bjpati/Thesis-2023/README.md

# Thesis-2023
The goal of this thesis is to develop an embedded test system for monitoring current in a multiple channel neuromuscular electrical stimulation (NMES) system. The system is designed to detect overcurrent and leakage conditions and protect the patient from injury.
