bjpati/Thesis-2023/CircuitDesign/PCB_v10_new/THESIS_2023_v10.txt

For this version the design was changed because the previous design ware not work. The problem was in the common mode range of the
HV current sensing. instead the design was replaced with an instrumentation amplifier with voltage divider at the input. The PCB
needed to be re-routed.
