bjpati/Thesis-2023/CircuitDesign/PCB_v5/THESIS_2023_v5.txt

This is the fifth version where we have improved the PCB layout. In the previous version, the PCB became very large. 
In this version, we have reduced it by half. It is, however, still quite large, so we are thinking of making another new version where we 
utilize the back of the PCB more.
