bjpati/Thesis-2023/CircuitDesign/PCB_v9_final/NMEStestkort.xlsx

Id | Designator | Package | Quantity | Designation | Supplier and ref
1 | R12,R8,R29,R4,R27,R13,R2,R17,R26,R14,R23,R6,R9,R25,R10,R32,R31,R18,R16,R30,R19,R5,R3,R20,R24,R22,R21,R15,R1,R11,R28,R7 | R_0603_1608Metric_Pad0.98x0.95mm_HandSolder | 32 | 500
2 | Rout30,Rout10,Rout12,Rout18,Rout23,Rout32,Rout5,Rout6,Rout3,Rout29,Rout20,Rout31,Rout13,Rout26,Rout22,Rout21,Rout2,Rout27,Rout11,Rout8,Rout25,Rout9,Rout19,Rout15,Rout16,Rout17,Rout14,Rout4,Rout24,Rout28,Rout1,Rout7 | R_0603_1608Metric_Pad0.98x0.95mm_HandSolder | 32 | 10k
3 | Rin12,Rin29,Rin15,Rin9,Rin21,Rin3,Rin28,Rin17,Rin4,Rin16,Rin1,Rin13,Rin6,Rin19,Rin23,Rin5,Rin27,Rin7,Rin10,Rin8,Rin25,Rin30,Rin14,Rin18,Rin22,Rin11,Rin32,Rin31,Rin20,Rin26,Rin2,Rin24 | R_0603_1608Metric_Pad0.98x0.95mm_HandSolder | 32 | 150
4 | RDEV14,RDEV8,RDEV2,RDEV20,RDEV30,RDEV7,RDEV4,RDEV15,RDEV32,RDEV24,RDEV31,RDEV9,RDEV19,RDEV17,RDEV28,RDEV16,RDEV21,RDEV11,RDEV6,RDEV25,RDEV1,RDEV29,RDEV5,RDEV3,RDEV23,RDEV10,RDEV13,RDEV26,RDEV12,RDEV27,RDEV18 | R_0603_1608Metric_Pad0.98x0.95mm_HandSolder | 31 | 6k
5 | UHV21,UHV32,UHV30,UHV24,UHV2,UHV3,UHV7,UHV6,UHV12,UHV31,UHV14,UHV27,UHV17,UHV11,UHV8,UHV1,UHV25,UHV19,UHV5,UHV29,UHV20,UHV9,UHV16,UHV26,UHV28,UHV15,UHV10,UHV13,UHV4,UHV22,UHV18,UHV23 | SOT-23-5_HandSoldering | 32 | LT6106
6 | RDIV6,RDIV31,RDIV9,RDIV5,RDIV25,RDIV4,RDIV17,RDIV18,RDIV15,RDIV10,RDIV8,RDIV19,RDIV13,RDIV27,RDIV30,RDIV1,RDIV26,RDIV3,RDIV23,RDIV24,RDIV22,RDIV7,RDIV16,RDIV28,RDIV12,RDIV14,RDIV11,RDIV20,RDIV32,RDIV29,RDIV2,RDIV21 | R_0603_1608Metric_Pad0.98x0.95mm_HandSolder | 32 | 2k
7 | CUSB1,CReg1,CReg2,C10 | C_0805_2012Metric_Pad1.18x1.45mm_HandSolder | 4 | 1u
8 | RS9,RS1,RS32,RS26,RS8,RS19,RS10,RS18,RS14,RS3,RS4,RS13,RS30,RS20,RS31,RS17,RS29,RS25,RS21,RS15,RS7,RS27,RS24,RS28,RS22,RS12,RS2,RS6,RS16,RS5,RS11,RS23 | R_0603_1608Metric_Pad0.98x0.95mm_HandSolder | 32 | 1
9 | C11,C15,C12,C17,C16,C14,C18,C13 | CP_Elec_4x5.3 | 8 | 1u
10 | U1 | TSOT-23-5_HandSoldering | 1 | ADP151
11 | J4,J6 | PinSocket_1x03_P2.54mm_Vertical | 2 | Conn_01x03_Female
12 | JSTMleft1,JSTMright1 | PinSocket_1x15_P2.54mm_Vertical | 2 | Conn_01x15_Female
13 | H1,H4,H2,H3 | MountingHole_3.5mm_Pad | 4 | MountingHole
14 | J1,J2 | PinSocket_1x32_P2.54mm_Vertical | 2 | Conn_01x32_Female
15 | UCOM6,UCOM2,UCOM3,UCOM4,UCOM7,UCOM1,UCOM5,UCOM8 | TSSOP-14_4.4x5mm_P0.65mm | 8 | LM339
16 | C7,C6,C1,C4,C9,C3,C2,C8,C5 | C_0805_2012Metric_Pad1.18x1.45mm_HandSolder | 9 | 0.1u
17 | D1 | LED_1206_3216Metric_Pad1.42x1.75mm_HandSolder | 1 | LED
18 | TP1,TP4,TP2,TP3 | PinHeader_1x01_P2.54mm_Vertical | 4 | Conn_01x01_Female
19 | J3 | PinSocket_1x02_P2.54mm_Vertical | 1 | Conn_01x02_Female
20 | UDAC1 | MSOP-8_3x3mm_P0.65mm | 1 | MCP4921
21 | J7 | USB_Micro-B_Molex_47346-0001 | 1 | USB_B_Micro
22 | RDEV22,Rled1 | R_0603_1608Metric_Pad0.98x0.95mm_HandSolder | 2 | 1k
