bjpati/Thesis-2023/CircuitDesign/PCB_v11_final/NMEStestkort.kicad_pcb

## KiCad design CircuitDesign/PCB_v11_final/NMEStestkort.kicad_pcb (2023-05-22)

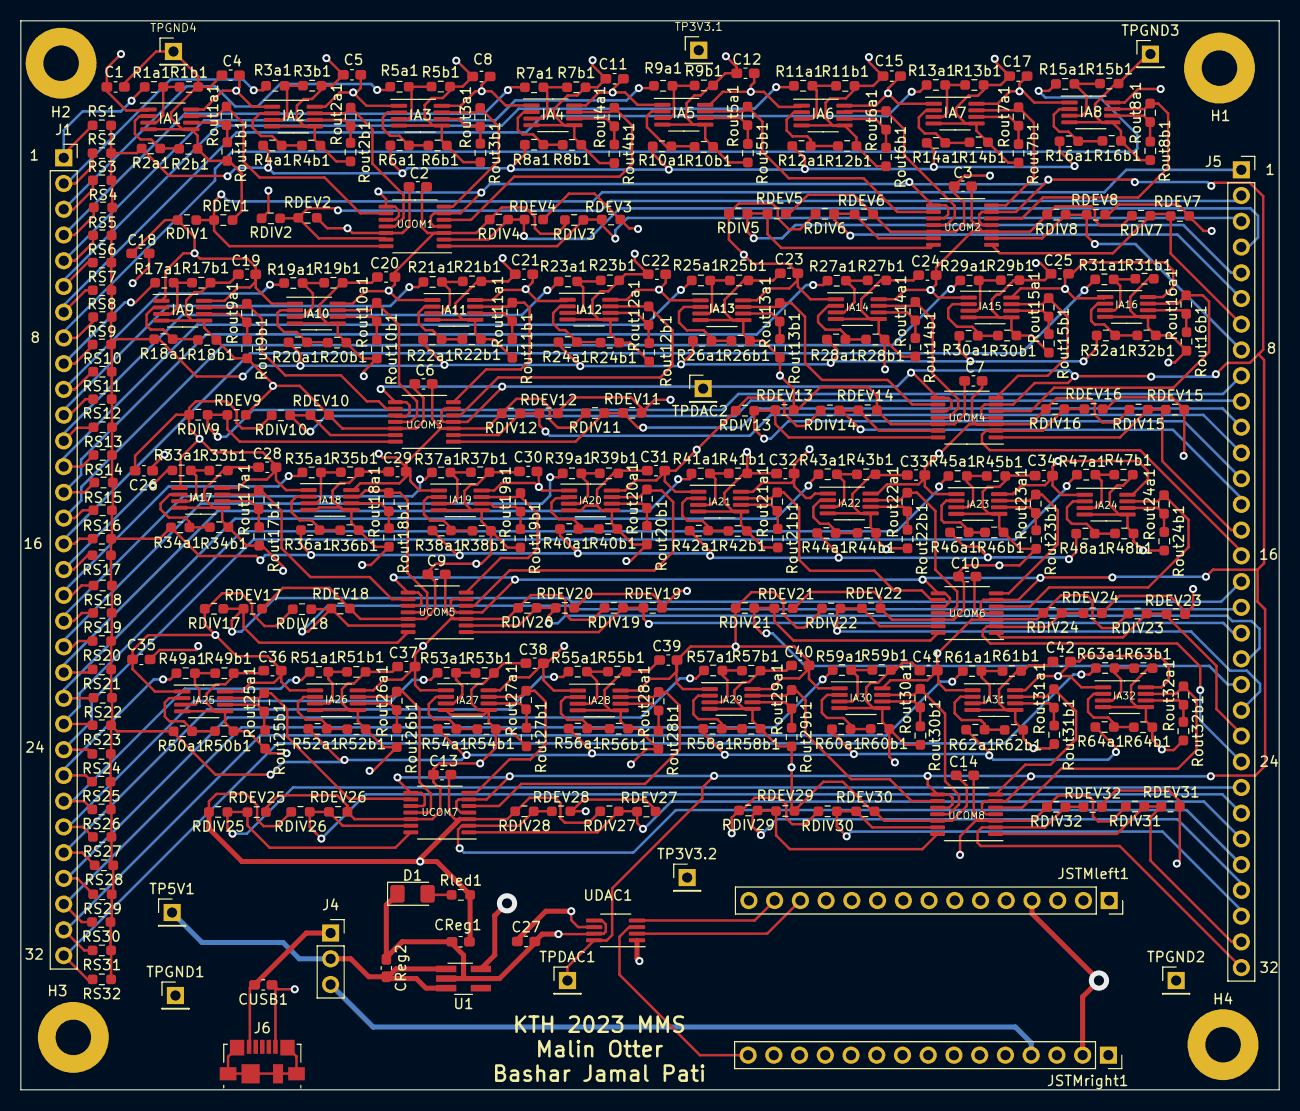
[picture p1: board CircuitDesign/PCB_v11_final/NMEStestkort.kicad_pcb from above]

Board: 4 copper layers, 124.2 x 105.5 mm, 395 parts (0 on the bottom side), 203 nets.

Parts:
C1, C2, C3, C4, C5, C6, C7, C8, C9, C10, C11, C12, C13, C14, C15, C17, C18, C19, C20, C21, C22, C23, C24, C25, C26, C27, C28, C29, C30, C31, C32, C33, C34, C35, C36, C37, C38, C39, C40, C41, C42: 0.1u; C_0603_1608Metric_Pad1.08x0.95mm_HandSolder
CReg1, CReg2: 1u; C_0603_1608Metric_Pad1.08x0.95mm_HandSolder
CUSB1: 1u; C_0603_1608Metric_Pad1.08x0.95mm_HandSolder
D1: LED; LED_1206_3216Metric_Pad1.42x1.75mm_HandSolder
H1, H2, H3, H4: MountingHole; MountingHole_3.5mm_Pad
IA1, IA2, IA3, IA4, IA5, IA6, IA7, IA8, IA9, IA10, IA11, IA12, IA13, IA14, IA15, IA16, IA17, IA18, IA19, IA20, IA21, IA22, IA23, IA24, IA25, IA26, IA27, IA28, IA29, IA30, IA31, IA32: MCP6N16; MSOP-8_3x3mm_P0.65mm
J1, J5: Conn_01x32_Female; PinSocket_1x32_P2.54mm_Vertical
J4: Conn_01x03_Female; PinSocket_1x03_P2.54mm_Vertical
J6: USB_B_Micro; USB_Micro-B_Molex_47346-0001
JSTMleft1: Conn_01x15_Female; PinSocket_1x15_P2.54mm_Vertical
JSTMright1: Conn_01x15_Female; PinSocket_1x15_P2.54mm_Vertical
R1a1, R2a1, R3a1, R4a1, R5a1, R6a1, R7a1, R8a1, R9a1, R10a1, R11a1, R12a1, R13a1, R14a1, R15a1, R16a1, R17a1, R18a1, R19a1, R20a1, R21a1, R22a1, R23a1, R24a1, R25a1, R26a1, R27a1, R28a1, R29a1, R30a1, R31a1, R32a1, R33a1, R34a1, R35a1, R36a1, R37a1, R38a1, R39a1, R40a1, R41a1, R42a1, R43a1, R44a1, R45a1, R46a1, R47a1, R48a1, R49a1, R50a1, R51a1, R52a1, R53a1, R54a1, R55a1, R56a1, R57a1, R58a1, R59a1, R60a1, R61a1, R62a1, R63a1, R64a1: 47k; R_0603_1608Metric_Pad0.98x0.95mm_HandSolder
R1b1, R2b1, R3b1, R4b1, R5b1, R6b1, R7b1, R8b1, R9b1, R10b1, R11b1, R12b1, R13b1, R14b1, R15b1, R16b1, R17b1, R18b1, R19b1, R20b1, R21b1, R22b1, R23b1, R24b1, R25b1, R26b1, R27b1, R28b1, R29b1, R30b1, R31b1, R32b1, R33b1, R34b1, R35b1, R36b1, R37b1, R38b1, R39b1, R40b1, R41b1, R42b1, R43b1, R44b1, R45b1, R46b1, R47b1, R48b1, R49b1, R50b1, R51b1, R52b1, R53b1, R54b1, R55b1, R56b1, R57b1, R58b1, R59b1, R60b1, R61b1, R62b1, R63b1, R64b1: 470; R_0603_1608Metric_Pad0.98x0.95mm_HandSolder
RDEV1, RDEV2, RDEV3, RDEV4, RDEV5, RDEV6, RDEV7, RDEV8, RDEV9, RDEV10, RDEV11, RDEV12, RDEV13, RDEV14, RDEV15, RDEV16, RDEV17, RDEV18, RDEV19, RDEV20, RDEV21, RDEV22, RDEV23, RDEV24, RDEV25, RDEV26, RDEV27, RDEV28, RDEV29, RDEV30, RDEV31, RDEV32: 6k2; R_0603_1608Metric_Pad0.98x0.95mm_HandSolder
RDIV1, RDIV2, RDIV3, RDIV4, RDIV5, RDIV6, RDIV7, RDIV8, RDIV9, RDIV10, RDIV11, RDIV12, RDIV13, RDIV14, RDIV15, RDIV16, RDIV17, RDIV18, RDIV19, RDIV20, RDIV21, RDIV22, RDIV23, RDIV24, RDIV25, RDIV26, RDIV27, RDIV28, RDIV29, RDIV30, RDIV31, RDIV32: 2k2; R_0603_1608Metric_Pad0.98x0.95mm_HandSolder
RS1, RS2, RS3, RS4, RS5, RS6, RS7, RS8, RS9, RS10, RS11, RS12, RS13, RS14, RS15, RS16, RS17, RS18, RS19, RS20, RS21, RS22, RS23, RS24, RS25, RS26, RS27, RS28, RS29, RS30, RS31, RS32: 500; R_0603_1608Metric_Pad0.98x0.95mm_HandSolder
Rled1: 1k; R_0603_1608Metric_Pad0.98x0.95mm_HandSolder
Rout1a1, Rout2a1, Rout3a1, Rout4a1, Rout5a1, Rout6a1, Rout7a1, Rout8a1, Rout9a1, Rout10a1, Rout11a1, Rout12a1, Rout13a1, Rout14a1, Rout15a1, Rout16a1, Rout17a1, Rout18a1, Rout19a1, Rout20a1, Rout21a1, Rout22a1, Rout23a1, Rout24a1, Rout25a1, Rout26a1, Rout27a1, Rout28a1, Rout29a1, Rout30a1, Rout31a1, Rout32a1: 12k; R_0603_1608Metric_Pad0.98x0.95mm_HandSolder
Rout1b1, Rout2b1, Rout3b1, Rout4b1, Rout5b1, Rout6b1, Rout7b1, Rout8b1, Rout9b1, Rout10b1, Rout11b1, Rout12b1, Rout13b1, Rout14b1, Rout15b1, Rout16b1, Rout17b1, Rout18b1, Rout19b1, Rout20b1, Rout21b1, Rout22b1, Rout23b1, Rout24b1, Rout25b1, Rout26b1, Rout27b1, Rout28b1, Rout29b1, Rout30b1, Rout31b1, Rout32b1: 1k; R_0603_1608Metric_Pad0.98x0.95mm_HandSolder
TP3V3.1, TP3V3.2: Conn_01x02_Female; PinHeader_1x01_P2.54mm_Vertical
TP5V1: Conn_01x01_Female; PinHeader_1x01_P2.54mm_Vertical
TPDAC1, TPDAC2: Conn_01x01_Female; PinHeader_1x01_P2.54mm_Vertical
TPGND1, TPGND2, TPGND3, TPGND4: Conn_01x02_Female; PinHeader_1x01_P2.54mm_Vertical
U1: ADP151; TSOT-23-5_HandSoldering
UCOM1, UCOM2, UCOM3, UCOM4, UCOM5, UCOM6, UCOM7, UCOM8: LM339; TSSOP-14_4.4x5mm_P0.65mm
UDAC1: MCP4921; MSOP-8_3x3mm_P0.65mm

Connections:
+3.3V: C1.1, C2.1, C3.1, C4.1, C5.1, C6.1, C7.1, C8.1, C9.1, C10.1, C11.1, C12.1, C13.1, C14.1, C15.1, C17.1, C18.1, C19.1, C20.1, C21.1, C22.1, C23.1, C24.1, C25.1, C26.1, C27.1, C28.1, C29.1, C30.1, C31.1, C32.1, C33.1, C34.1, C35.1, C36.1, C37.1, C38.1, C39.1, C40.1, C41.1, C42.1, CReg1.1, IA1.1 (EN), IA1.8 (V+), IA2.1 (EN), IA2.8 (V+), IA3.1 (EN), IA3.8 (V+), IA4.1 (EN), IA4.8 (V+), IA5.1 (EN), IA5.8 (V+), IA6.1 (EN), IA6.8 (V+), IA7.1 (EN), IA7.8 (V+), IA8.1 (EN), IA8.8 (V+), IA9.1 (EN), IA9.8 (V+), IA10.1 (EN), IA10.8 (V+), IA11.1 (EN), IA11.8 (V+), IA12.1 (EN), IA12.8 (V+), IA13.1 (EN), IA13.8 (V+), IA14.1 (EN), IA14.8 (V+), IA15.1 (EN), IA15.8 (V+), IA16.1 (EN), IA16.8 (V+), IA17.1 (EN), IA17.8 (V+), IA18.1 (EN), IA18.8 (V+), IA19.1 (EN), IA19.8 (V+), IA20.1 (EN), IA20.8 (V+), IA21.1 (EN), IA21.8 (V+), IA22.1 (EN), IA22.8 (V+), IA23.1 (EN), IA23.8 (V+), IA24.1 (EN), IA24.8 (V+), IA25.1 (EN), IA25.8 (V+), IA26.1 (EN), IA26.8 (V+), IA27.1 (EN), IA27.8 (V+), IA28.1 (EN), IA28.8 (V+), IA29.1 (EN), IA29.8 (V+), IA30.1 (EN), IA30.8 (V+), IA31.1 (EN), IA31.8 (V+), IA32.1 (EN), IA32.8 (V+), RDIV1.2, RDIV2.2, RDIV3.2, RDIV4.2, RDIV5.2, RDIV6.2, RDIV7.2, RDIV8.2, RDIV9.2, RDIV10.2, RDIV11.2, RDIV12.2, RDIV13.2, RDIV14.2, RDIV15.2, RDIV16.2, RDIV17.2, RDIV18.2, RDIV19.2, RDIV20.2, RDIV21.2, RDIV22.2, RDIV23.2, RDIV24.2, RDIV25.2, RDIV26.2, RDIV27.2, RDIV28.2, RDIV29.2, RDIV30.2, RDIV31.2, RDIV32.2, Rled1.2, TP3V3.1.1, TP3V3.2.1, U1.5 (VOUT), UCOM1.3 (V+), UCOM2.3 (V+), UCOM3.3 (V+), UCOM4.3 (V+), UCOM5.3 (V+), UCOM6.3 (V+), UCOM7.3 (V+), UCOM8.3 (V+), UDAC1.1 (Vdd), UDAC1.6 (Vref)
+5V: CReg2.2, J4.2, TP5V1.1, U1.1 (VIN), U1.3 (EN)
+5V MCU: J4.3, JSTMright1.4
+5V USB: CUSB1.2, J4.1, J6.1 (VBUS)
DAC output: TPDAC1.1, TPDAC2.1, UCOM1.4 (-), UCOM1.6 (-), UCOM1.8 (-), UCOM1.10 (-), UCOM2.4 (-), UCOM2.6 (-), UCOM2.8 (-), UCOM2.10 (-), UCOM3.4 (-), UCOM3.6 (-), UCOM3.8 (-), UCOM3.10 (-), UCOM4.4 (-), UCOM4.6 (-), UCOM4.8 (-), UCOM4.10 (-), UCOM5.4 (-), UCOM5.6 (-), UCOM5.8 (-), UCOM5.10 (-), UCOM6.4 (-), UCOM6.6 (-), UCOM6.8 (-), UCOM6.10 (-), UCOM7.4 (-), UCOM7.6 (-), UCOM7.8 (-), UCOM7.10 (-), UCOM8.4 (-), UCOM8.6 (-), UCOM8.8 (-), UCOM8.10 (-), UDAC1.8 (Vout)
GND: C1.2, C2.2, C3.2, C4.2, C5.2, C6.2, C7.2, C8.2, C9.2, C10.2, C11.2, C12.2, C13.2, C14.2, C15.2, C17.2, C18.2, C19.2, C20.2, C21.2, C22.2, C23.2, C24.2, C25.2, C26.2, C27.2, C28.2, C29.2, C30.2, C31.2, C32.2, C33.2, C34.2, C35.2, C36.2, C37.2, C38.2, C39.2, C40.2, C41.2, C42.2, CReg1.2, CReg2.1, CUSB1.1, D1.1 (K), IA1.4 (V-), IA1.5 (Vref), IA2.4 (V-), IA2.5 (Vref), IA3.4 (V-), IA3.5 (Vref), IA4.4 (V-), IA4.5 (Vref), IA5.4 (V-), IA5.5 (Vref), IA6.4 (V-), IA6.5 (Vref), IA7.4 (V-), IA7.5 (Vref), IA8.4 (V-), IA8.5 (Vref), IA9.4 (V-), IA9.5 (Vref), IA10.4 (V-), IA10.5 (Vref), IA11.4 (V-), IA11.5 (Vref), IA12.4 (V-), IA12.5 (Vref), IA13.4 (V-), IA13.5 (Vref), IA14.4 (V-), IA14.5 (Vref), IA15.4 (V-), IA15.5 (Vref), IA16.4 (V-), IA16.5 (Vref), IA17.4 (V-), IA17.5 (Vref), IA18.4 (V-), IA18.5 (Vref), IA19.4 (V-), IA19.5 (Vref), IA20.4 (V-), IA20.5 (Vref), IA21.4 (V-), IA21.5 (Vref), IA22.4 (V-), IA22.5 (Vref), IA23.4 (V-), IA23.5 (Vref), IA24.4 (V-), IA24.5 (Vref), IA25.4 (V-), IA25.5 (Vref), IA26.4 (V-), IA26.5 (Vref), IA27.4 (V-), IA27.5 (Vref), IA28.4 (V-), IA28.5 (Vref), IA29.4 (V-), IA29.5 (Vref), IA30.4 (V-), IA30.5 (Vref), IA31.4 (V-), IA31.5 (Vref), IA32.4 (V-), IA32.5 (Vref), J6.5 (GND), JSTMleft1.4, JSTMright1.2, R1b1.2, R2b1.2, R3b1.2, R4b1.2, R5b1.2, R6b1.2, R7b1.2, R8b1.2, R9b1.2, R10b1.2, R11b1.2, R12b1.2, R13b1.2, R14b1.2, R15b1.2, R16b1.2, R17b1.2, R18b1.2, R19b1.2, R20b1.2, R21b1.2, R22b1.2, R23b1.2, R24b1.2, R25b1.2, R26b1.2, R27b1.2, R28b1.2, R29b1.2, R30b1.2, R31b1.2, R32b1.2, R33b1.2, R34b1.2, R35b1.2, R36b1.2, R37b1.2, R38b1.2, R39b1.2, R40b1.2, R41b1.2, R42b1.2, R43b1.2, R44b1.2, R45b1.2, R46b1.2, R47b1.2, R48b1.2, R49b1.2, R50b1.2, R51b1.2, R52b1.2, R53b1.2, R54b1.2, R55b1.2, R56b1.2, R57b1.2, R58b1.2, R59b1.2, R60b1.2, R61b1.2, R62b1.2, R63b1.2, R64b1.2, RDEV1.1, RDEV2.1, RDEV3.1, RDEV4.1, RDEV5.1, RDEV6.1, RDEV7.1, RDEV8.1, RDEV9.1, RDEV10.1, RDEV11.1, RDEV12.1, RDEV13.1, RDEV14.1, RDEV15.1, RDEV16.1, RDEV17.1, RDEV18.1, RDEV19.1, RDEV20.1, RDEV21.1, RDEV22.1, RDEV23.1, RDEV24.1, RDEV25.1, RDEV26.1, RDEV27.1, RDEV28.1, RDEV29.1, RDEV30.1, RDEV31.1, RDEV32.1, Rout1b1.2, Rout2b1.2, Rout3b1.2, Rout4b1.2, Rout5b1.2, Rout6b1.2, Rout7b1.2, Rout8b1.2, Rout9b1.2, Rout10b1.2, Rout11b1.2, Rout12b1.2, Rout13b1.2, Rout14b1.2, Rout15b1.2, Rout16b1.2, Rout17b1.2, Rout18b1.2, Rout19b1.2, Rout20b1.2, Rout21b1.2, Rout22b1.2, Rout23b1.2, Rout24b1.2, Rout25b1.2, Rout26b1.2, Rout27b1.2, Rout28b1.2, Rout29b1.2, Rout30b1.2, Rout31b1.2, Rout32b1.2, TPGND1.1, TPGND2.1, TPGND3.1, TPGND4.1, U1.2 (GND), UCOM1.12 (V-), UCOM2.12 (V-), UCOM3.12 (V-), UCOM4.12 (V-), UCOM5.12 (V-), UCOM6.12 (V-), UCOM7.12 (V-), UCOM8.12 (V-), UDAC1.5 (~LDAC), UDAC1.7 (Vss)
unnamed: D1.2 (A), Rled1.1
unnamed: IA1.2 (-), R2a1.1, R2b1.1
unnamed: IA1.3 (+), R1a1.1, R1b1.1
unnamed: IA1.6 (Vfg), Rout1a1.1, Rout1b1.1
unnamed: IA1.7 (Vout), Rout1a1.2, UCOM1.9 (+)
unnamed: IA2.2 (-), R4a1.1, R4b1.1
unnamed: IA2.3 (+), R3a1.1, R3b1.1
unnamed: IA2.6 (Vfg), Rout2a1.1, Rout2b1.1
unnamed: IA2.7 (Vout), Rout2a1.2, UCOM1.11 (+)
unnamed: IA3.2 (-), R6a1.1, R6b1.1
unnamed: IA3.3 (+), R5a1.1, R5b1.1
unnamed: IA3.6 (Vfg), Rout3a1.1, Rout3b1.1
unnamed: IA3.7 (Vout), Rout3a1.2, UCOM1.7 (+)
unnamed: IA4.2 (-), R8a1.1, R8b1.1
unnamed: IA4.3 (+), R7a1.1, R7b1.1
unnamed: IA4.6 (Vfg), Rout4a1.1, Rout4b1.1
unnamed: IA4.7 (Vout), Rout4a1.2, UCOM1.5 (+)
unnamed: IA5.2 (-), R10a1.1, R10b1.1
unnamed: IA5.3 (+), R9a1.1, R9b1.1
unnamed: IA5.6 (Vfg), Rout5a1.1, Rout5b1.1
unnamed: IA5.7 (Vout), Rout5a1.2, UCOM2.9 (+)
unnamed: IA6.2 (-), R12a1.1, R12b1.1
unnamed: IA6.3 (+), R11a1.1, R11b1.1
unnamed: IA6.6 (Vfg), Rout6a1.1, Rout6b1.1
unnamed: IA6.7 (Vout), Rout6a1.2, UCOM2.11 (+)
unnamed: IA7.2 (-), R14a1.1, R14b1.1
unnamed: IA7.3 (+), R13a1.1, R13b1.1
unnamed: IA7.6 (Vfg), Rout7a1.1, Rout7b1.1
unnamed: IA7.7 (Vout), Rout7a1.2, UCOM2.7 (+)
unnamed: IA8.2 (-), R16a1.1, R16b1.1
unnamed: IA8.3 (+), R15a1.1, R15b1.1
unnamed: IA8.6 (Vfg), Rout8a1.1, Rout8b1.1
unnamed: IA8.7 (Vout), Rout8a1.2, UCOM2.5 (+)
unnamed: IA9.2 (-), R18a1.1, R18b1.1
unnamed: IA9.3 (+), R17a1.1, R17b1.1
unnamed: IA9.6 (Vfg), Rout9a1.1, Rout9b1.1
unnamed: IA9.7 (Vout), Rout9a1.2, UCOM3.9 (+)
unnamed: IA10.2 (-), R20a1.1, R20b1.1
unnamed: IA10.3 (+), R19a1.1, R19b1.1
unnamed: IA10.6 (Vfg), Rout10a1.1, Rout10b1.1
unnamed: IA10.7 (Vout), Rout10a1.2, UCOM3.11 (+)
unnamed: IA11.2 (-), R22a1.1, R22b1.1
unnamed: IA11.3 (+), R21a1.1, R21b1.1
unnamed: IA11.6 (Vfg), Rout11a1.1, Rout11b1.1
unnamed: IA11.7 (Vout), Rout11a1.2, UCOM3.7 (+)
unnamed: IA12.2 (-), R24a1.1, R24b1.1
unnamed: IA12.3 (+), R23a1.1, R23b1.1
unnamed: IA12.6 (Vfg), Rout12a1.1, Rout12b1.1
unnamed: IA12.7 (Vout), Rout12a1.2, UCOM3.5 (+)
unnamed: IA13.2 (-), R26a1.1, R26b1.1
unnamed: IA13.3 (+), R25a1.1, R25b1.1
unnamed: IA13.6 (Vfg), Rout13a1.1, Rout13b1.1
unnamed: IA13.7 (Vout), Rout13a1.2, UCOM4.9 (+)
unnamed: IA14.2 (-), R28a1.1, R28b1.1
unnamed: IA14.3 (+), R27a1.1, R27b1.1
unnamed: IA14.6 (Vfg), Rout14a1.1, Rout14b1.1
unnamed: IA14.7 (Vout), Rout14a1.2, UCOM4.11 (+)
unnamed: IA15.2 (-), R30a1.1, R30b1.1
unnamed: IA15.3 (+), R29a1.1, R29b1.1
unnamed: IA15.6 (Vfg), Rout15a1.1, Rout15b1.1
unnamed: IA15.7 (Vout), Rout15a1.2, UCOM4.7 (+)
unnamed: IA16.2 (-), R32a1.1, R32b1.1
unnamed: IA16.3 (+), R31a1.1, R31b1.1
unnamed: IA16.6 (Vfg), Rout16a1.1, Rout16b1.1
unnamed: IA16.7 (Vout), Rout16a1.2, UCOM4.5 (+)
unnamed: IA17.2 (-), R34a1.1, R34b1.1
unnamed: IA17.3 (+), R33a1.1, R33b1.1
unnamed: IA17.6 (Vfg), Rout17a1.1, Rout17b1.1
unnamed: IA17.7 (Vout), Rout17a1.2, UCOM5.9 (+)
unnamed: IA18.2 (-), R36a1.1, R36b1.1
unnamed: IA18.3 (+), R35a1.1, R35b1.1
unnamed: IA18.6 (Vfg), Rout18a1.1, Rout18b1.1
unnamed: IA18.7 (Vout), Rout18a1.2, UCOM5.11 (+)
unnamed: IA19.2 (-), R38a1.1, R38b1.1
unnamed: IA19.3 (+), R37a1.1, R37b1.1
unnamed: IA19.6 (Vfg), Rout19a1.1, Rout19b1.1
unnamed: IA19.7 (Vout), Rout19a1.2, UCOM5.7 (+)
unnamed: IA20.2 (-), R40a1.1, R40b1.1
unnamed: IA20.3 (+), R39a1.1, R39b1.1
unnamed: IA20.6 (Vfg), Rout20a1.1, Rout20b1.1
unnamed: IA20.7 (Vout), Rout20a1.2, UCOM5.5 (+)
unnamed: IA21.2 (-), R42a1.1, R42b1.1
unnamed: IA21.3 (+), R41a1.1, R41b1.1
unnamed: IA21.6 (Vfg), Rout21a1.1, Rout21b1.1
unnamed: IA21.7 (Vout), Rout21a1.2, UCOM6.9 (+)
unnamed: IA22.2 (-), R44a1.1, R44b1.1
unnamed: IA22.3 (+), R43a1.1, R43b1.1
unnamed: IA22.6 (Vfg), Rout22a1.1, Rout22b1.1
unnamed: IA22.7 (Vout), Rout22a1.2, UCOM6.11 (+)
unnamed: IA23.2 (-), R46a1.1, R46b1.1
unnamed: IA23.3 (+), R45a1.1, R45b1.1
unnamed: IA23.6 (Vfg), Rout23a1.1, Rout23b1.1
unnamed: IA23.7 (Vout), Rout23a1.2, UCOM6.7 (+)
unnamed: IA24.2 (-), R48a1.1, R48b1.1
unnamed: IA24.3 (+), R47a1.1, R47b1.1
unnamed: IA24.6 (Vfg), Rout24a1.1, Rout24b1.1
unnamed: IA24.7 (Vout), Rout24a1.2, UCOM6.5 (+)
unnamed: IA25.2 (-), R50a1.1, R50b1.1
unnamed: IA25.3 (+), R49a1.1, R49b1.1
unnamed: IA25.6 (Vfg), Rout25a1.1, Rout25b1.1
unnamed: IA25.7 (Vout), Rout25a1.2, UCOM7.9 (+)
unnamed: IA26.2 (-), R52a1.1, R52b1.1
unnamed: IA26.3 (+), R51a1.1, R51b1.1
unnamed: IA26.6 (Vfg), Rout26a1.1, Rout26b1.1
unnamed: IA26.7 (Vout), Rout26a1.2, UCOM7.11 (+)
unnamed: IA27.2 (-), R54a1.1, R54b1.1
unnamed: IA27.3 (+), R53a1.1, R53b1.1
unnamed: IA27.6 (Vfg), Rout27a1.1, Rout27b1.1
unnamed: IA27.7 (Vout), Rout27a1.2, UCOM7.7 (+)
unnamed: IA28.2 (-), R56a1.1, R56b1.1
unnamed: IA28.3 (+), R55a1.1, R55b1.1
unnamed: IA28.6 (Vfg), Rout28a1.1, Rout28b1.1
unnamed: IA28.7 (Vout), Rout28a1.2, UCOM7.5 (+)
unnamed: IA29.2 (-), R58a1.1, R58b1.1
unnamed: IA29.3 (+), R57a1.1, R57b1.1
unnamed: IA29.6 (Vfg), Rout29a1.1, Rout29b1.1
unnamed: IA29.7 (Vout), Rout29a1.2, UCOM8.9 (+)
unnamed: IA30.2 (-), R60a1.1, R60b1.1
unnamed: IA30.3 (+), R59a1.1, R59b1.1
unnamed: IA30.6 (Vfg), Rout30a1.1, Rout30b1.1
unnamed: IA30.7 (Vout), Rout30a1.2, UCOM8.11 (+)
unnamed: IA31.2 (-), R62a1.1, R62b1.1
unnamed: IA31.3 (+), R61a1.1, R61b1.1
unnamed: IA31.6 (Vfg), Rout31a1.1, Rout31b1.1
unnamed: IA31.7 (Vout), Rout31a1.2, UCOM8.7 (+)
unnamed: IA32.2 (-), R64a1.1, R64b1.1
unnamed: IA32.3 (+), R63a1.1, R63b1.1
unnamed: IA32.6 (Vfg), Rout32a1.1, Rout32b1.1
unnamed: IA32.7 (Vout), Rout32a1.2, UCOM8.5 (+)
unnamed: J1.1, R1a1.2, RS1.2
unnamed: J1.2, R3a1.2, RS2.2
unnamed: J1.3, R5a1.2, RS3.2
unnamed: J1.4, R7a1.2, RS4.2
unnamed: J1.5, R9a1.2, RS5.2
unnamed: J1.6, R11a1.2, RS6.2
unnamed: J1.7, R13a1.2, RS7.2
unnamed: J1.8, R15a1.2, RS8.2
unnamed: J1.9, R17a1.2, RS9.2
unnamed: J1.10, R19a1.2, RS10.2
unnamed: J1.11, R21a1.2, RS11.2
unnamed: J1.12, R23a1.2, RS12.2
unnamed: J1.13, R25a1.2, RS13.2
unnamed: J1.14, R27a1.2, RS14.2
unnamed: J1.15, R29a1.2, RS15.2
unnamed: J1.16, R31a1.2, RS16.2
unnamed: J1.17, R33a1.2, RS17.2
unnamed: J1.18, R35a1.2, RS18.2
unnamed: J1.19, R37a1.2, RS19.2
unnamed: J1.20, R39a1.2, RS20.2
unnamed: J1.21, R41a1.2, RS21.2
unnamed: J1.22, R43a1.2, RS22.2
unnamed: J1.23, R45a1.2, RS23.2
unnamed: J1.24, R47a1.2, RS24.2
unnamed: J1.25, R49a1.2, RS25.2
unnamed: J1.26, R51a1.2, RS26.2
unnamed: J1.27, R53a1.2, RS27.2
unnamed: J1.28, R55a1.2, RS28.2
unnamed: J1.29, R57a1.2, RS29.2
unnamed: J1.30, R59a1.2, RS30.2
unnamed: J1.31, R61a1.2, RS31.2
unnamed: J1.32, R63a1.2, RS32.2
unnamed: J5.1, RDEV1.2, RDIV1.1, UCOM1.14
unnamed: J5.2, RDEV2.2, RDIV2.1, UCOM1.13
unnamed: J5.3, RDEV3.2, RDIV3.1, UCOM1.1
unnamed: J5.4, RDEV4.2, RDIV4.1, UCOM1.2
unnamed: J5.5, RDEV5.2, RDIV5.1, UCOM2.14
unnamed: J5.6, RDEV6.2, RDIV6.1, UCOM2.13
unnamed: J5.7, RDEV7.2, RDIV7.1, UCOM2.1
unnamed: J5.8, RDEV8.2, RDIV8.1, UCOM2.2
unnamed: J5.9, RDEV9.2, RDIV9.1, UCOM3.14
unnamed: J5.10, RDEV10.2, RDIV10.1, UCOM3.13
unnamed: J5.11, RDEV11.2, RDIV11.1, UCOM3.1
unnamed: J5.12, RDEV12.2, RDIV12.1, UCOM3.2
unnamed: J5.13, RDEV13.2, RDIV13.1, UCOM4.14
unnamed: J5.14, RDEV14.2, RDIV14.1, UCOM4.13
unnamed: J5.15, RDEV15.2, RDIV15.1, UCOM4.1
unnamed: J5.16, RDEV16.2, RDIV16.1, UCOM4.2
unnamed: J5.17, RDEV17.2, RDIV17.1, UCOM5.14
unnamed: J5.18, RDEV18.2, RDIV18.1, UCOM5.13
unnamed: J5.19, RDEV19.2, RDIV19.1, UCOM5.1
unnamed: J5.20, RDEV20.2, RDIV20.1, UCOM5.2
unnamed: J5.21, RDEV21.2, RDIV21.1, UCOM6.14
unnamed: J5.22, RDEV22.2, RDIV22.1, UCOM6.13
unnamed: J5.23, RDEV23.2, RDIV23.1, UCOM6.1
unnamed: J5.24, RDEV24.2, RDIV24.1, UCOM6.2
unnamed: J5.25, RDEV25.2, RDIV25.1, UCOM7.14
unnamed: J5.26, RDEV26.2, RDIV26.1, UCOM7.13
unnamed: J5.27, RDEV27.2, RDIV27.1, UCOM7.1
unnamed: J5.28, RDEV28.2, RDIV28.1, UCOM7.2
unnamed: J5.29, RDEV29.2, RDIV29.1, UCOM8.14
unnamed: J5.30, RDEV30.2, RDIV30.1, UCOM8.13
unnamed: J5.31, RDEV31.2, RDIV31.1, UCOM8.1
unnamed: J5.32, RDEV32.2, RDIV32.1, UCOM8.2
unnamed: R2a1.2, R4a1.2, R6a1.2, R8a1.2, R10a1.2, R12a1.2, R14a1.2, R16a1.2, R18a1.2, R20a1.2, R22a1.2, R24a1.2, R26a1.2, R28a1.2, R30a1.2, R32a1.2, R34a1.2, R36a1.2, R38a1.2, R40a1.2, R42a1.2, R44a1.2, R46a1.2, R48a1.2, R50a1.2, R52a1.2, R54a1.2, R56a1.2, R58a1.2, R60a1.2, R62a1.2, R64a1.2, RS1.1, RS2.1, RS3.1, RS4.1, RS5.1, RS6.1, RS7.1, RS8.1, RS9.1, RS10.1, RS11.1, RS12.1, RS13.1, RS14.1, RS15.1, RS16.1, RS17.1, RS18.1, RS19.1, RS20.1, RS21.1, RS22.1, RS23.1, RS24.1, RS25.1, RS26.1, RS27.1, RS28.1, RS29.1, RS30.1, RS31.1, RS32.1
SCK: JSTMright1.15, UDAC1.3 (SCK)
SPI_CS: JSTMleft1.13, UDAC1.2 (~CS)
SPI_MOSI: JSTMleft1.14, UDAC1.4 (SDI)
