bjpati/Thesis-2023/CircuitDesign/PCB_v6_v7/THESIS_2023_v6_v7/NMEStestkort.kicad_pcb

## KiCad design CircuitDesign/PCB_v6_v7/THESIS_2023_v6_v7/NMEStestkort.kicad_pcb (2023-04-24, an earlier design)

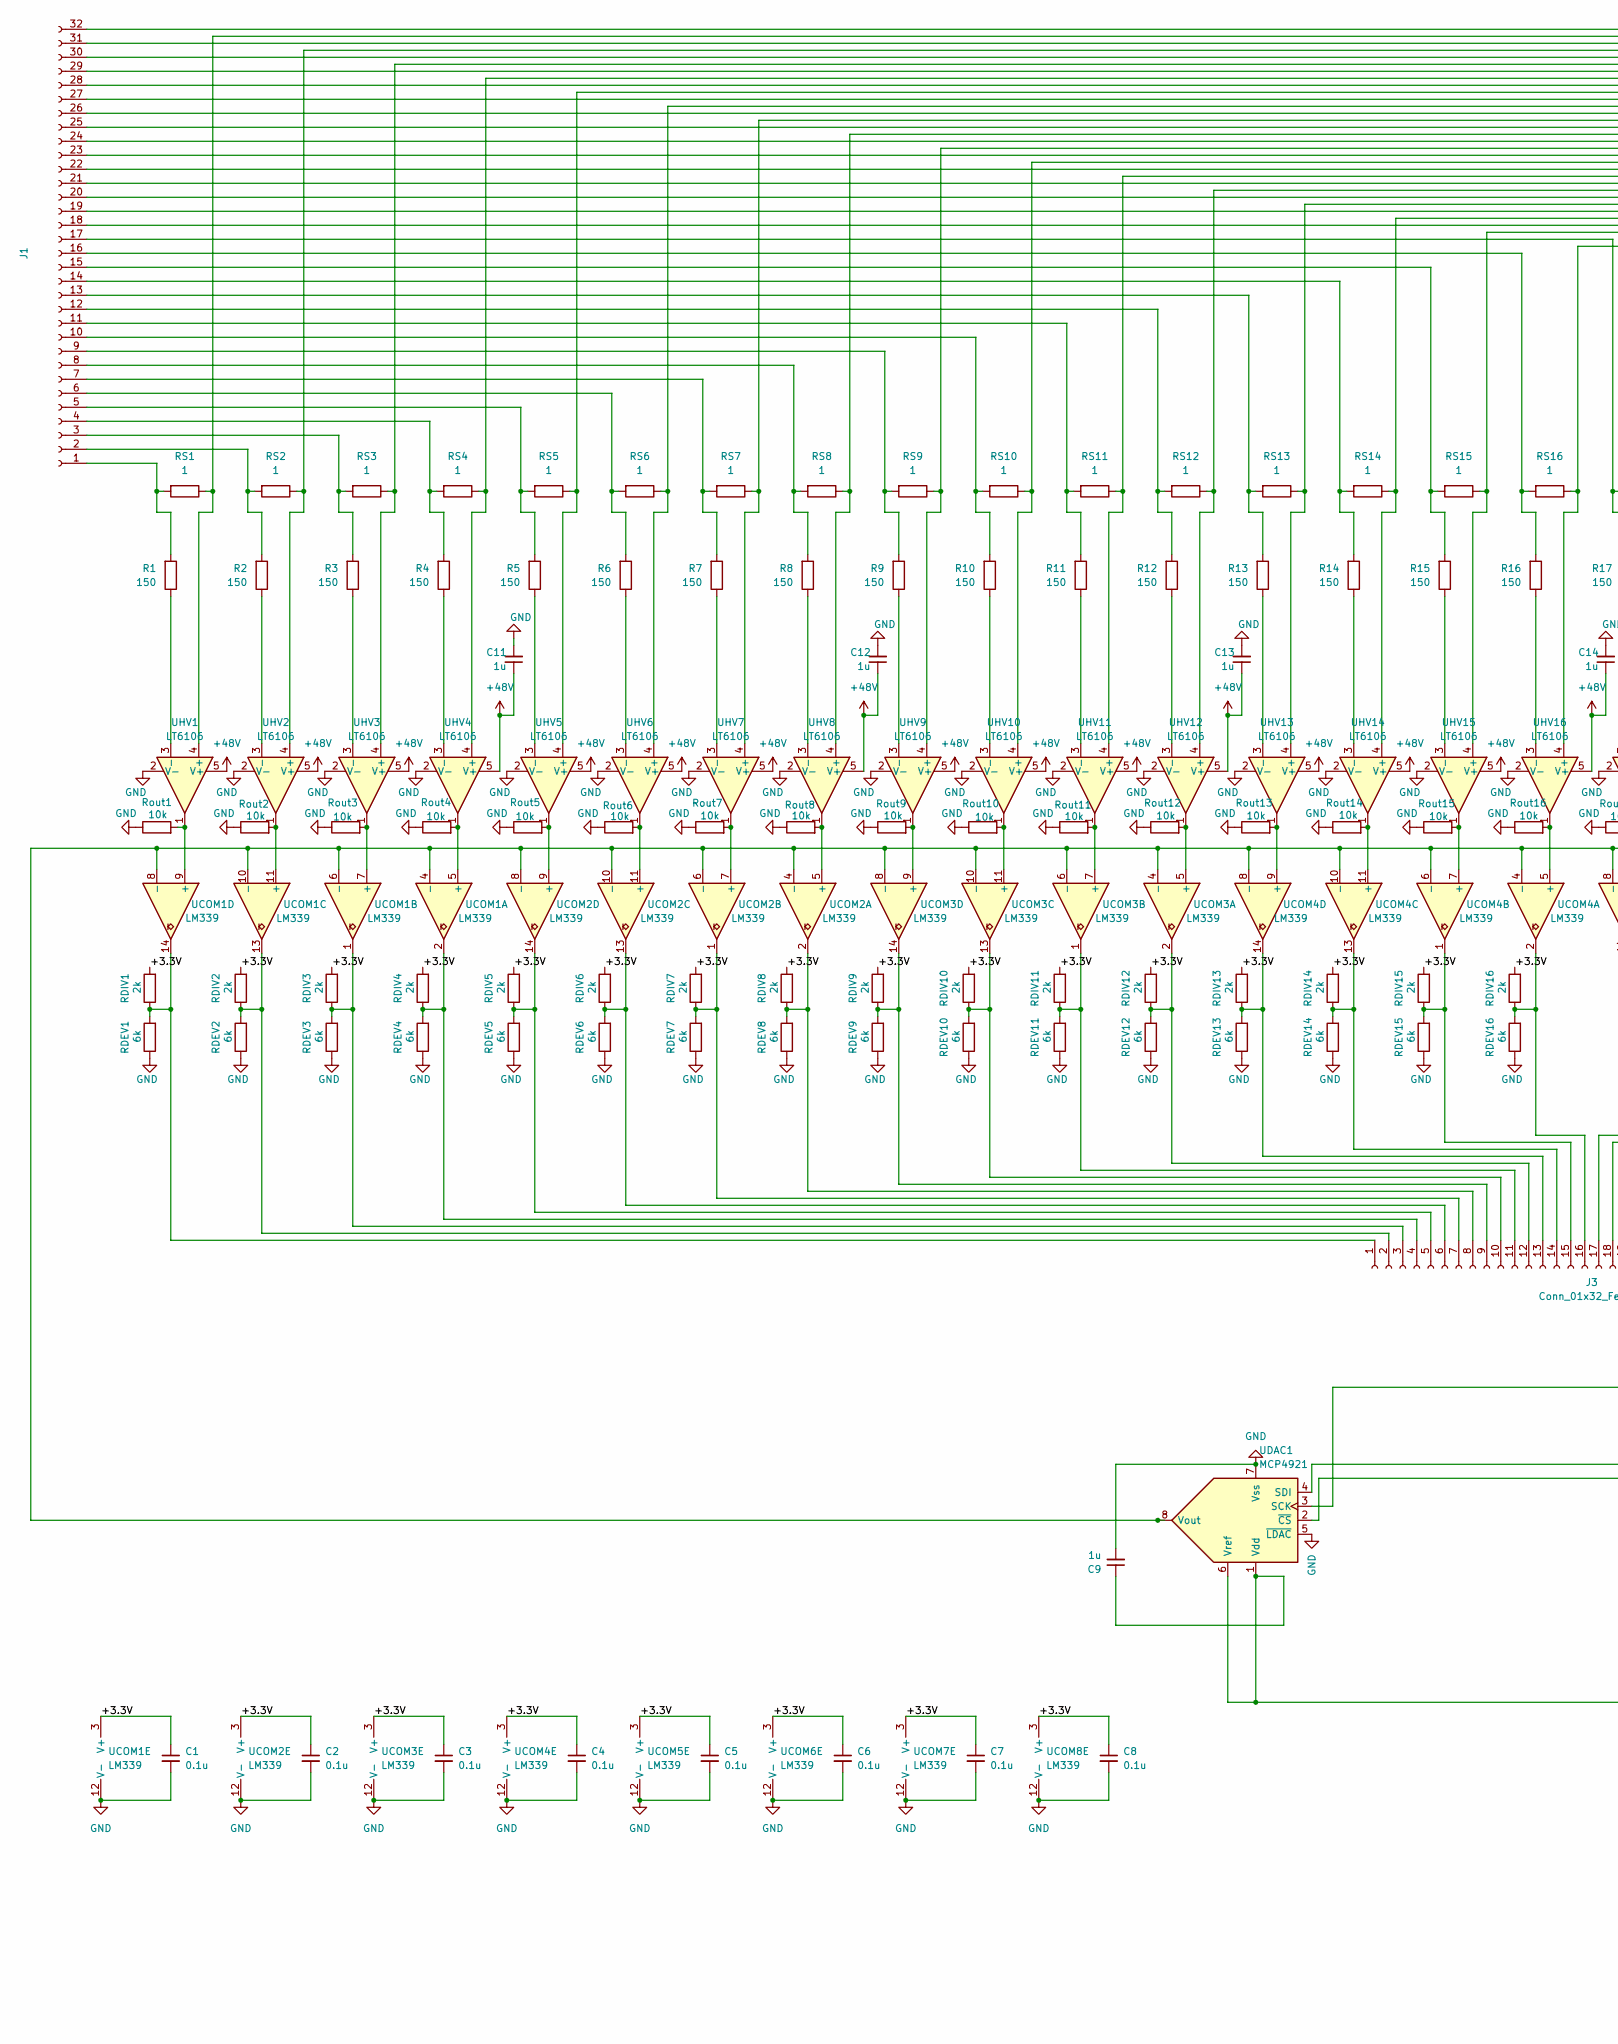
[picture p5: schematic NMEStestkort.kicad_sch, part in row 1, column 1]

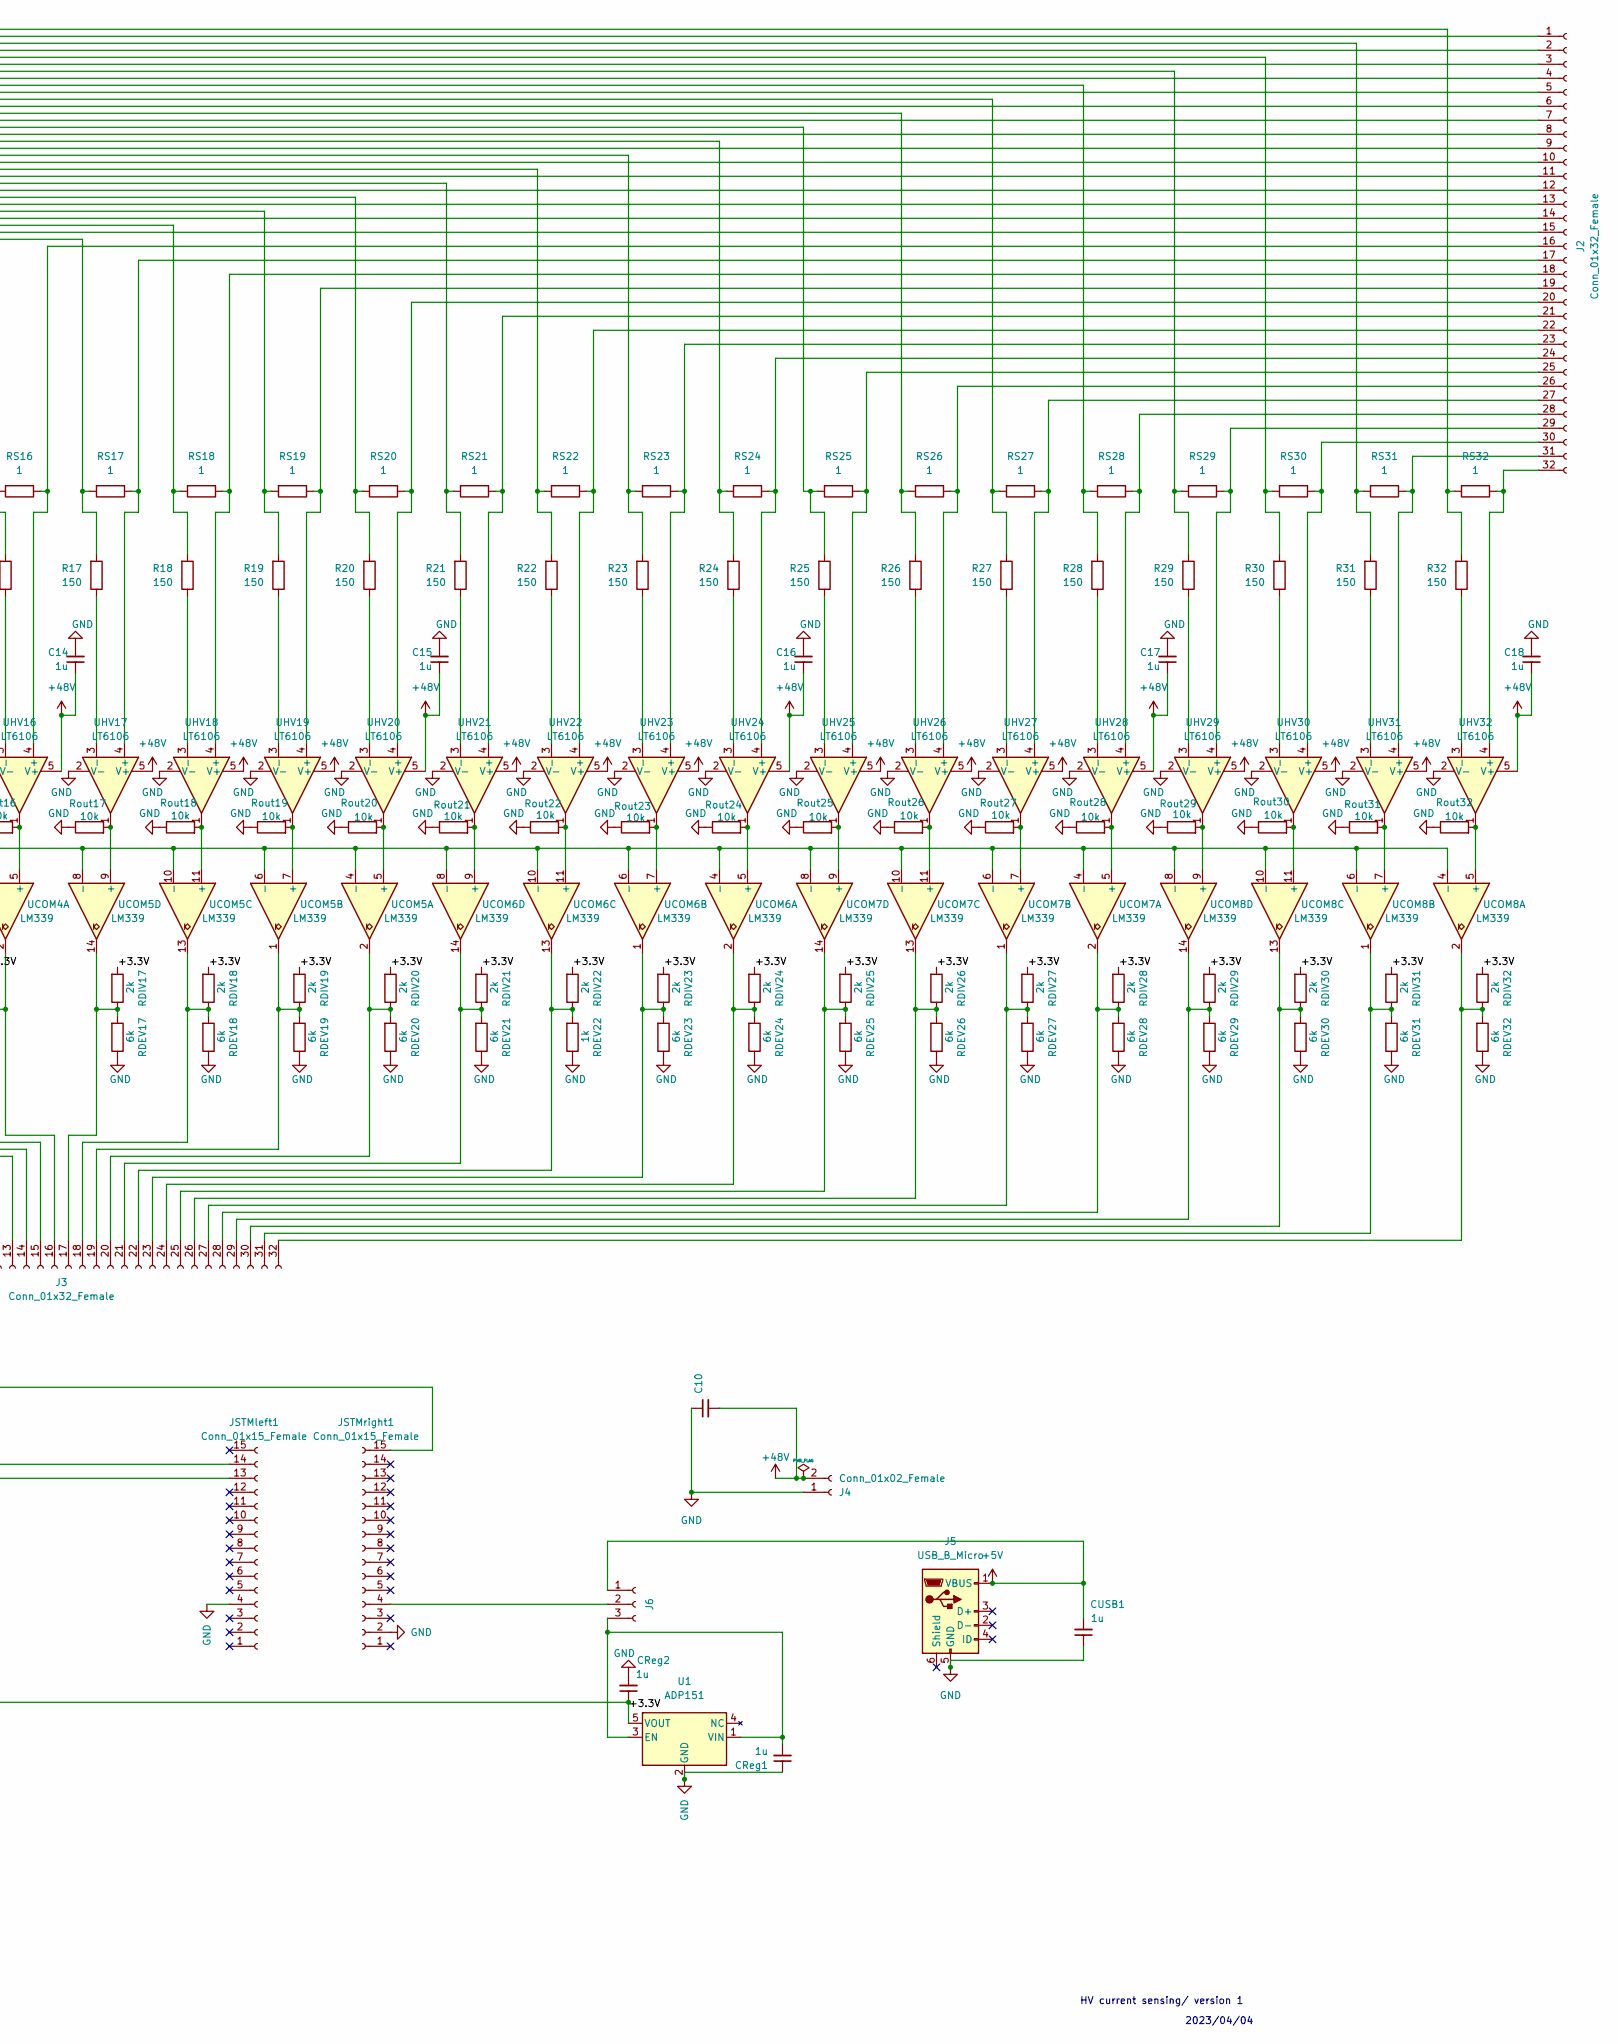
[picture p6: schematic NMEStestkort.kicad_sch, part in row 1, column 2]

Parts:
C1, C2, C3, C4, C5, C6, C7, C8: 0.1u; C_0805_2012Metric_Pad1.18x1.45mm_HandSolder
C9: 1u; C_0805_2012Metric_Pad1.18x1.45mm_HandSolder
C10: C_0805_2012Metric_Pad1.18x1.45mm_HandSolder
C11, C12, C13, C14, C15, C16, C17, C18: 1u; CP_Elec_4x5.3
CReg1, CReg2: 1u; C_0805_2012Metric_Pad1.18x1.45mm_HandSolder
CUSB1: 1u; C_0805_2012Metric_Pad1.18x1.45mm_HandSolder
J1, J6: (no value)
J2, J3: Conn_01x32_Female; PinSocket_1x32_P2.54mm_Vertical
J4: Conn_01x02_Female; PinSocket_1x02_P2.54mm_Vertical
J5: USB_B_Micro; USB_Micro-B_Molex_47346-0001
JSTMleft1: Conn_01x15_Female; PinSocket_1x15_P2.54mm_Vertical
JSTMright1: Conn_01x15_Female; PinSocket_1x15_P2.54mm_Vertical
R1, R2, R3, R4, R5, R6, R7, R8, R9, R10, R11, R12, R13, R14, R15, R16, R17, R18, R19, R20, R21, R22, R23, R24, R25, R26, R27, R28, R29, R30, R31, R32: 150; R_0603_1608Metric_Pad0.98x0.95mm_HandSolder
RDEV1, RDEV2, RDEV3, RDEV4, RDEV5, RDEV6, RDEV7, RDEV8, RDEV9, RDEV10, RDEV11, RDEV12, RDEV13, RDEV14, RDEV15, RDEV16, RDEV17, RDEV18, RDEV19, RDEV20, RDEV21, RDEV23, RDEV24, RDEV25, RDEV26, RDEV27, RDEV28, RDEV29, RDEV30, RDEV31, RDEV32: 6k; R_0603_1608Metric_Pad0.98x0.95mm_HandSolder
RDEV22: 1k; R_0603_1608Metric_Pad0.98x0.95mm_HandSolder
RDIV1, RDIV2, RDIV3, RDIV4, RDIV5, RDIV6, RDIV7, RDIV8, RDIV9, RDIV10, RDIV11, RDIV12, RDIV13, RDIV14, RDIV15, RDIV16, RDIV17, RDIV18, RDIV19, RDIV20, RDIV21, RDIV22, RDIV23, RDIV24, RDIV25, RDIV26, RDIV27, RDIV28, RDIV29, RDIV30, RDIV31, RDIV32: 2k; R_0603_1608Metric_Pad0.98x0.95mm_HandSolder
RS1, RS2, RS3, RS4, RS5, RS6, RS7, RS8, RS9, RS10, RS11, RS12, RS13, RS14, RS15, RS16, RS17, RS18, RS19, RS20, RS21, RS22, RS23, RS24, RS25, RS26, RS27, RS28, RS29, RS30, RS31, RS32: 1; R_0603_1608Metric_Pad0.98x0.95mm_HandSolder
Rout1, Rout2, Rout3, Rout4, Rout5, Rout6, Rout7, Rout8, Rout9, Rout10, Rout11, Rout12, Rout13, Rout14, Rout15, Rout16, Rout17, Rout18, Rout19, Rout20, Rout21, Rout22, Rout23, Rout24, Rout25, Rout26, Rout27, Rout28, Rout29, Rout30, Rout31, Rout32: 10k; R_0603_1608Metric_Pad0.98x0.95mm_HandSolder
U1: ADP151; TSOT-23-5_HandSoldering
UCOM1, UCOM2, UCOM3, UCOM4, UCOM5, UCOM6, UCOM7, UCOM8: LM339; TSSOP-14_4.4x5mm_P0.65mm
UDAC1: MCP4921; MSOP-8_3x3mm_P0.65mm
UHV1, UHV2, UHV3, UHV4, UHV5, UHV6, UHV7, UHV8, UHV9, UHV10, UHV11, UHV12, UHV13, UHV14, UHV15, UHV16, UHV17, UHV18, UHV19, UHV20, UHV21, UHV22, UHV23, UHV24, UHV25, UHV26, UHV27, UHV28, UHV29, UHV30, UHV31, UHV32: LT6106; SOT-23-5_HandSoldering

Connections:
+5V: CUSB1.2, J5.1 (VBUS), J6.1
+48V: C10.2, C11.1, C12.1, C13.1, C14.1, C15.1, C16.1, C17.1, C18.1, J4.2, UHV1.5 (V+), UHV2.5 (V+), UHV3.5 (V+), UHV4.5 (V+), UHV5.5 (V+), UHV6.5 (V+), UHV7.5 (V+), UHV8.5 (V+), UHV9.5 (V+), UHV10.5 (V+), UHV11.5 (V+), UHV12.5 (V+), UHV13.5 (V+), UHV14.5 (V+), UHV15.5 (V+), UHV16.5 (V+), UHV17.5 (V+), UHV18.5 (V+), UHV19.5 (V+), UHV20.5 (V+), UHV21.5 (V+), UHV22.5 (V+), UHV23.5 (V+), UHV24.5 (V+), UHV25.5 (V+), UHV26.5 (V+), UHV27.5 (V+), UHV28.5 (V+), UHV29.5 (V+), UHV30.5 (V+), UHV31.5 (V+), UHV32.5 (V+)
/+3.3V: C1.1, C2.1, C3.1, C4.1, C5.1, C6.1, C7.1, C8.1, C9.1, CReg2.1, RDIV1.2, RDIV2.2, RDIV3.2, RDIV4.2, RDIV5.2, RDIV6.2, RDIV7.2, RDIV8.2, RDIV9.2, RDIV10.2, RDIV11.2, RDIV12.2, RDIV13.2, RDIV14.2, RDIV15.2, RDIV16.2, RDIV17.2, RDIV18.2, RDIV19.2, RDIV20.2, RDIV21.2, RDIV22.2, RDIV23.2, RDIV24.2, RDIV25.2, RDIV26.2, RDIV27.2, RDIV28.2, RDIV29.2, RDIV30.2, RDIV31.2, RDIV32.2, U1.5 (VOUT), UCOM1.3 (V+), UCOM2.3 (V+), UCOM3.3 (V+), UCOM4.3 (V+), UCOM5.3 (V+), UCOM6.3 (V+), UCOM7.3 (V+), UCOM8.3 (V+), UDAC1.1 (Vdd), UDAC1.6 (Vref)
GND: C1.2, C2.2, C3.2, C4.2, C5.2, C6.2, C7.2, C8.2, C9.2, C10.1, C11.2, C12.2, C13.2, C14.2, C15.2, C16.2, C17.2, C18.2, CReg1.1, CReg2.2, CUSB1.1, J4.1, J5.5 (GND), JSTMleft1.4, JSTMright1.2, RDEV1.1, RDEV2.1, RDEV3.1, RDEV4.1, RDEV5.1, RDEV6.1, RDEV7.1, RDEV8.1, RDEV9.1, RDEV10.1, RDEV11.1, RDEV12.1, RDEV13.1, RDEV14.1, RDEV15.1, RDEV16.1, RDEV17.1, RDEV18.1, RDEV19.1, RDEV20.1, RDEV21.1, RDEV22.1, RDEV23.1, RDEV24.1, RDEV25.1, RDEV26.1, RDEV27.1, RDEV28.1, RDEV29.1, RDEV30.1, RDEV31.1, RDEV32.1, Rout1.1, Rout2.1, Rout3.1, Rout4.1, Rout5.1, Rout6.1, Rout7.1, Rout8.1, Rout9.1, Rout10.1, Rout11.1, Rout12.1, Rout13.1, Rout14.1, Rout15.1, Rout16.1, Rout17.1, Rout18.1, Rout19.1, Rout20.1, Rout21.1, Rout22.1, Rout23.1, Rout24.1, Rout25.1, Rout26.1, Rout27.1, Rout28.1, Rout29.1, Rout30.1, Rout31.1, Rout32.1, U1.2 (GND), UCOM1.12 (V-), UCOM2.12 (V-), UCOM3.12 (V-), UCOM4.12 (V-), UCOM5.12 (V-), UCOM6.12 (V-), UCOM7.12 (V-), UCOM8.12 (V-), UDAC1.5 (~LDAC), UDAC1.7 (Vss), UHV1.2 (V-), UHV2.2 (V-), UHV3.2 (V-), UHV4.2 (V-), UHV5.2 (V-), UHV6.2 (V-), UHV7.2 (V-), UHV8.2 (V-), UHV9.2 (V-), UHV10.2 (V-), UHV11.2 (V-), UHV12.2 (V-), UHV13.2 (V-), UHV14.2 (V-), UHV15.2 (V-), UHV16.2 (V-), UHV17.2 (V-), UHV18.2 (V-), UHV19.2 (V-), UHV20.2 (V-), UHV21.2 (V-), UHV22.2 (V-), UHV23.2 (V-), UHV24.2 (V-), UHV25.2 (V-), UHV26.2 (V-), UHV27.2 (V-), UHV28.2 (V-), UHV29.2 (V-), UHV30.2 (V-), UHV31.2 (V-), UHV32.2 (V-)
unnamed: CReg1.2, J6.3, U1.1 (VIN), U1.3 (EN)
unnamed: J1.1, R1.2, RS1.2
unnamed: J1.2, R2.2, RS2.2
unnamed: J1.3, R3.2, RS3.2
unnamed: J1.4, R4.2, RS4.2
unnamed: J1.5, R5.2, RS5.2
unnamed: J1.6, R6.2, RS6.2
unnamed: J1.7, R7.2, RS7.2
unnamed: J1.8, R8.2, RS8.2
unnamed: J1.9, R9.2, RS9.2
unnamed: J1.10, R10.2, RS10.2
unnamed: J1.11, R11.2, RS11.2
unnamed: J1.12, R12.2, RS12.2
unnamed: J1.13, R13.2, RS13.2
unnamed: J1.14, R14.2, RS14.2
unnamed: J1.15, R15.2, RS15.2
unnamed: J1.16, R16.2, RS16.2
unnamed: J1.17, R17.2, RS17.2
unnamed: J1.18, R18.2, RS18.2
unnamed: J1.19, R19.2, RS19.2
unnamed: J1.20, R20.2, RS20.2
unnamed: J1.21, R21.2, RS21.2
unnamed: J1.22, R22.2, RS22.2
unnamed: J1.23, R23.2, RS23.2
unnamed: J1.24, R24.2, RS24.2
unnamed: J1.25, R25.2, RS25.2
unnamed: J1.26, R26.2, RS26.2
unnamed: J1.27, R27.2, RS27.2
unnamed: J1.28, R28.2, RS28.2
unnamed: J1.29, R29.2, RS29.2
unnamed: J1.30, R30.2, RS30.2
unnamed: J1.31, R31.2, RS31.2
unnamed: J1.32, R32.2, RS32.2
unnamed: J2.1, RS1.1, UHV1.4 (+)
unnamed: J2.2, RS2.1, UHV2.4 (+)
unnamed: J2.3, RS3.1, UHV3.4 (+)
unnamed: J2.4, RS4.1, UHV4.4 (+)
unnamed: J2.5, RS5.1, UHV5.4 (+)
unnamed: J2.6, RS6.1, UHV6.4 (+)
unnamed: J2.7, RS7.1, UHV7.4 (+)
unnamed: J2.8, RS8.1, UHV8.4 (+)
unnamed: J2.9, RS9.1, UHV9.4 (+)
unnamed: J2.10, RS10.1, UHV10.4 (+)
unnamed: J2.11, RS11.1, UHV11.4 (+)
unnamed: J2.12, RS12.1, UHV12.4 (+)
unnamed: J2.13, RS13.1, UHV13.4 (+)
unnamed: J2.14, RS14.1, UHV14.4 (+)
unnamed: J2.15, RS15.1, UHV15.4 (+)
unnamed: J2.16, RS16.1, UHV16.4 (+)
unnamed: J2.17, RS17.1, UHV17.4 (+)
unnamed: J2.18, RS18.1, UHV18.4 (+)
unnamed: J2.19, RS19.1, UHV19.4 (+)
unnamed: J2.20, RS20.1, UHV20.4 (+)
unnamed: J2.21, RS21.1, UHV21.4 (+)
unnamed: J2.22, RS22.1, UHV22.4 (+)
unnamed: J2.23, RS23.1, UHV23.4 (+)
unnamed: J2.24, RS24.1, UHV24.4 (+)
unnamed: J2.25, RS25.1, UHV25.4 (+)
unnamed: J2.26, RS26.1, UHV26.4 (+)
unnamed: J2.27, RS27.1, UHV27.4 (+)
unnamed: J2.28, RS28.1, UHV28.4 (+)
unnamed: J2.29, RS29.1, UHV29.4 (+)
unnamed: J2.30, RS30.1, UHV30.4 (+)
unnamed: J2.31, RS31.1, UHV31.4 (+)
unnamed: J2.32, RS32.1, UHV32.4 (+)
unnamed: J3.1, RDEV1.2, RDIV1.1, UCOM1.14
unnamed: J3.2, RDEV2.2, RDIV2.1, UCOM1.13
unnamed: J3.3, RDEV3.2, RDIV3.1, UCOM1.1
unnamed: J3.4, RDEV4.2, RDIV4.1, UCOM1.2
unnamed: J3.5, RDEV5.2, RDIV5.1, UCOM2.14
unnamed: J3.6, RDEV6.2, RDIV6.1, UCOM2.13
unnamed: J3.7, RDEV7.2, RDIV7.1, UCOM2.1
unnamed: J3.8, RDEV8.2, RDIV8.1, UCOM2.2
unnamed: J3.9, RDEV9.2, RDIV9.1, UCOM3.14
unnamed: J3.10, RDEV10.2, RDIV10.1, UCOM3.13
unnamed: J3.11, RDEV11.2, RDIV11.1, UCOM3.1
unnamed: J3.12, RDEV12.2, RDIV12.1, UCOM3.2
unnamed: J3.13, RDEV13.2, RDIV13.1, UCOM4.14
unnamed: J3.14, RDEV14.2, RDIV14.1, UCOM4.13
unnamed: J3.15, RDEV15.2, RDIV15.1, UCOM4.1
unnamed: J3.16, RDEV16.2, RDIV16.1, UCOM4.2
unnamed: J3.17, RDEV17.2, RDIV17.1, UCOM5.14
unnamed: J3.18, RDEV18.2, RDIV18.1, UCOM5.13
unnamed: J3.19, RDEV19.2, RDIV19.1, UCOM5.1
unnamed: J3.20, RDEV20.2, RDIV20.1, UCOM5.2
unnamed: J3.21, RDEV21.2, RDIV21.1, UCOM6.14
unnamed: J3.22, RDEV22.2, RDIV22.1, UCOM6.13
unnamed: J3.23, RDEV23.2, RDIV23.1, UCOM6.1
unnamed: J3.24, RDEV24.2, RDIV24.1, UCOM6.2
unnamed: J3.25, RDEV25.2, RDIV25.1, UCOM7.14
unnamed: J3.26, RDEV26.2, RDIV26.1, UCOM7.13
unnamed: J3.27, RDEV27.2, RDIV27.1, UCOM7.1
unnamed: J3.28, RDEV28.2, RDIV28.1, UCOM7.2
unnamed: J3.29, RDEV29.2, RDIV29.1, UCOM8.14
unnamed: J3.30, RDEV30.2, RDIV30.1, UCOM8.13
unnamed: J3.31, RDEV31.2, RDIV31.1, UCOM8.1
unnamed: J3.32, RDEV32.2, RDIV32.1, UCOM8.2
unnamed: JSTMleft1.13, UDAC1.2 (~CS)
unnamed: JSTMleft1.14, UDAC1.4 (SDI)
unnamed: J6.2, JSTMright1.4
unnamed: JSTMright1.15, UDAC1.3 (SCK)
unnamed: R1.1, UHV1.3 (-)
unnamed: R2.1, UHV2.3 (-)
unnamed: R3.1, UHV3.3 (-)
unnamed: R4.1, UHV4.3 (-)
unnamed: R5.1, UHV5.3 (-)
unnamed: R6.1, UHV6.3 (-)
unnamed: R7.1, UHV7.3 (-)
unnamed: R8.1, UHV8.3 (-)
unnamed: R9.1, UHV9.3 (-)
unnamed: R10.1, UHV10.3 (-)
unnamed: R11.1, UHV11.3 (-)
unnamed: R12.1, UHV12.3 (-)
unnamed: R13.1, UHV13.3 (-)
unnamed: R14.1, UHV14.3 (-)
unnamed: R15.1, UHV15.3 (-)
unnamed: R16.1, UHV16.3 (-)
unnamed: R17.1, UHV17.3 (-)
unnamed: R18.1, UHV18.3 (-)
unnamed: R19.1, UHV19.3 (-)
unnamed: R20.1, UHV20.3 (-)
unnamed: R21.1, UHV21.3 (-)
unnamed: R22.1, UHV22.3 (-)
unnamed: R23.1, UHV23.3 (-)
unnamed: R24.1, UHV24.3 (-)
unnamed: R25.1, UHV25.3 (-)
unnamed: R26.1, UHV26.3 (-)
unnamed: R27.1, UHV27.3 (-)
unnamed: R28.1, UHV28.3 (-)
unnamed: R29.1, UHV29.3 (-)
unnamed: R30.1, UHV30.3 (-)
unnamed: R31.1, UHV31.3 (-)
unnamed: R32.1, UHV32.3 (-)
unnamed: Rout1.2, UCOM1.9 (+), UHV1.1
unnamed: Rout2.2, UCOM1.11 (+), UHV2.1
unnamed: Rout3.2, UCOM1.7 (+), UHV3.1
unnamed: Rout4.2, UCOM1.5 (+), UHV4.1
unnamed: Rout5.2, UCOM2.9 (+), UHV5.1
unnamed: Rout6.2, UCOM2.11 (+), UHV6.1
unnamed: Rout7.2, UCOM2.7 (+), UHV7.1
unnamed: Rout8.2, UCOM2.5 (+), UHV8.1
unnamed: Rout9.2, UCOM3.9 (+), UHV9.1
unnamed: Rout10.2, UCOM3.11 (+), UHV10.1
unnamed: Rout11.2, UCOM3.7 (+), UHV11.1
unnamed: Rout12.2, UCOM3.5 (+), UHV12.1
unnamed: Rout13.2, UCOM4.9 (+), UHV13.1
unnamed: Rout14.2, UCOM4.11 (+), UHV14.1
unnamed: Rout15.2, UCOM4.7 (+), UHV15.1
unnamed: Rout16.2, UCOM4.5 (+), UHV16.1
unnamed: Rout17.2, UCOM5.9 (+), UHV17.1
unnamed: Rout18.2, UCOM5.11 (+), UHV18.1
unnamed: Rout19.2, UCOM5.7 (+), UHV19.1
unnamed: Rout20.2, UCOM5.5 (+), UHV20.1
unnamed: Rout21.2, UCOM6.9 (+), UHV21.1
unnamed: Rout22.2, UCOM6.11 (+), UHV22.1
unnamed: Rout23.2, UCOM6.7 (+), UHV23.1
unnamed: Rout24.2, UCOM6.5 (+), UHV24.1
unnamed: Rout25.2, UCOM7.9 (+), UHV25.1
unnamed: Rout26.2, UCOM7.11 (+), UHV26.1
unnamed: Rout27.2, UCOM7.7 (+), UHV27.1
unnamed: Rout28.2, UCOM7.5 (+), UHV28.1
unnamed: Rout29.2, UCOM8.9 (+), UHV29.1
unnamed: Rout30.2, UCOM8.11 (+), UHV30.1
unnamed: Rout31.2, UCOM8.7 (+), UHV31.1
unnamed: Rout32.2, UCOM8.5 (+), UHV32.1
unnamed: UCOM1.4 (-), UCOM1.6 (-), UCOM1.8 (-), UCOM1.10 (-), UCOM2.4 (-), UCOM2.6 (-), UCOM2.8 (-), UCOM2.10 (-), UCOM3.4 (-), UCOM3.6 (-), UCOM3.8 (-), UCOM3.10 (-), UCOM4.4 (-), UCOM4.6 (-), UCOM4.8 (-), UCOM4.10 (-), UCOM5.4 (-), UCOM5.6 (-), UCOM5.8 (-), UCOM5.10 (-), UCOM6.4 (-), UCOM6.6 (-), UCOM6.8 (-), UCOM6.10 (-), UCOM7.4 (-), UCOM7.6 (-), UCOM7.8 (-), UCOM7.10 (-), UCOM8.4 (-), UCOM8.6 (-), UCOM8.8 (-), UCOM8.10 (-), UDAC1.8 (Vout)

Notes on the sheet:
2023/04/04
HV current sensing/ version 1

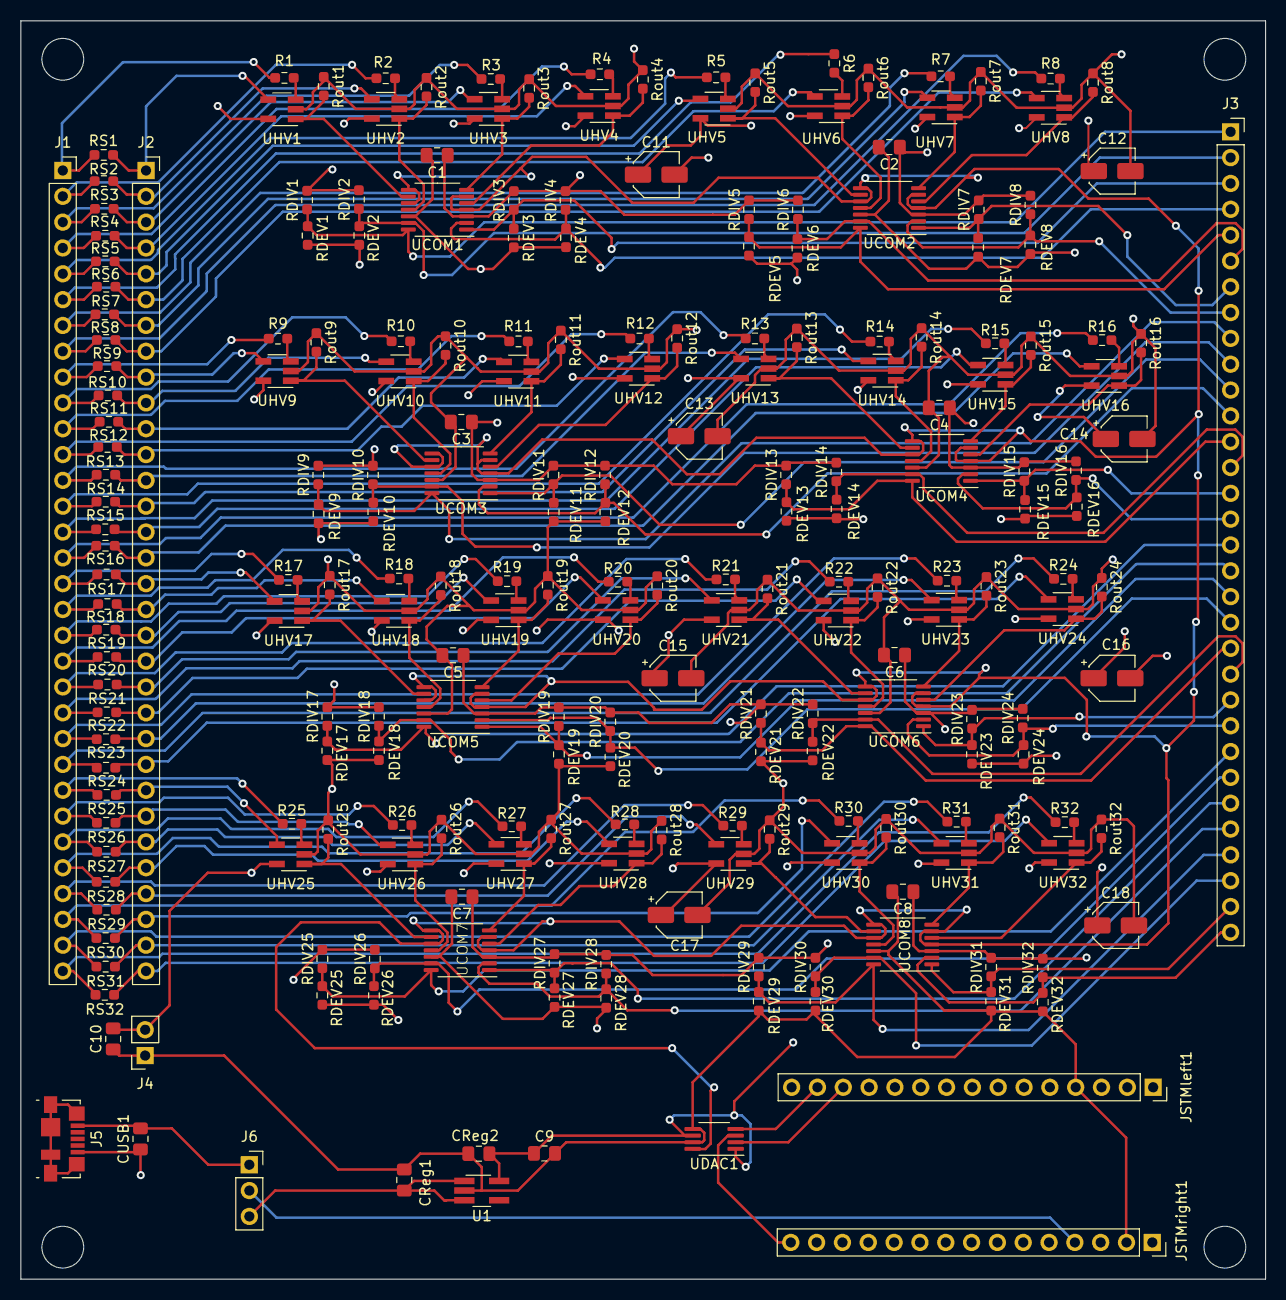
[picture p7: board CircuitDesign/PCB_v6_v7/THESIS_2023_v6_v7/NMEStestkort.kicad_pcb from above]

Board: 4 copper layers, 122.4 x 123.8 mm, 231 parts (0 on the bottom side), 170 nets.
