bjpati/Thesis-2023/stm_qt_communication/Core/Src/main.c

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
/* Includes ------------------------------------------------------------------*/
#include "main.h"
#include "spi.h"
#include "usart.h"
#include "gpio.h"

/* USER CODE BEGIN Includes */
#include <string.h>
#include "stm32l0xx_hal.h"
#include "dac.h"
/* USER CODE END Includes */

/* USER CODE BEGIN PD */
#define BUFFER_SIZE 8
/* USER CODE END PD */


void SystemClock_Config(void);
/* USER CODE BEGIN 0 */
unsigned short receiveDouble()
{
    uint8_t buffer[BUFFER_SIZE];

    while (HAL_UART_Receive(&huart2, buffer,2, HAL_MAX_DELAY) != HAL_OK)
    {
        // Handle receive error
    	//return 0;
    }
    HAL_UART_Transmit(&huart2, &buffer, 2, HAL_MAX_DELAY);

    uint16_t aux;
    aux = 0;
    aux = (buffer[1] << 8) & 0xff00;
    aux |= (buffer[0]) & 0x00ff;

    return aux;
}
/* USER CODE END 0 */

/**
  * @brief  The application entry point.
  * @retval int
  */
int main(void)
{

  /* USER CODE BEGIN 1 */
	uint16_t receiveValue;

  /* USER CODE END 1 */

  /* MCU Configuration--------------------------------------------------------*/

  /* Reset of all peripherals, Initializes the Flash interface and the Systick. */
  HAL_Init();

  /* Configure the system clock */
  SystemClock_Config();

  /* Initialize all configured peripherals */
  MX_GPIO_Init();
  MX_USART2_UART_Init();
  MX_SPI1_Init();
  /* USER CODE BEGIN 2 */

/* Start receiving data */
// uint8_t spiData[2];

  /* USER CODE END 2 */

  /* Infinite loop */
  /* USER CODE BEGIN WHILE */
  while (1)
  {

	 receiveValue= receiveDouble();

	/* Send a reference voltage to DAC */
	 DAC_SetVoltage(receiveValue);
	 //SPI_SendData(0xBB8);
	 HAL_Delay(20);
    /* USER CODE END WHILE */

    /* USER CODE BEGIN 3 */
  }
  /* USER CODE END 3 */
}

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
