bjpati/Thesis-2023/stm_qt_communication/Core/Inc/dac.h

/*
 * dac.h
 *
 *  Created on: Jun 13, 2023
 *      Author: malin
 */

#ifndef INC_DAC_H_
#define INC_DAC_H_

#include "stm32l0xx_hal.h"

void DAC_SetVoltage(uint16_t voltage);

#endif /* INC_DAC_H_ */
