bjpati/Thesis-2023/(commit log)

2023-04-11 put all PCB in same folder
2023-04-24 PCB update
    [NMEStestkort.kicad_pcb, NMEStestkort.kicad_sch]
2023-05-03 Update with final PCB version
    [NMEStestkort.kicad_pcb, NMEStestkort.kicad_sch, NMEStestkort.xlsx]
2023-05-19 Update with new version (IA)
    [NMEStestkort.kicad_pcb, NMEStestkort.kicad_sch]
2023-05-22 update with the final version
    [NMEStestkort.kicad_pcb, NMEStestkort.kicad_sch]
